SiluniPasqual/ParcelSafe-Locker/Final Project Report - ParcelSafe - 22UG2-0145,22UG2-0215_compressed.pdf

# ParcelSafe - Secure Delivery Locker System

MINI PROJECT REPORT

Embedded Systems Design Project

EEE2301

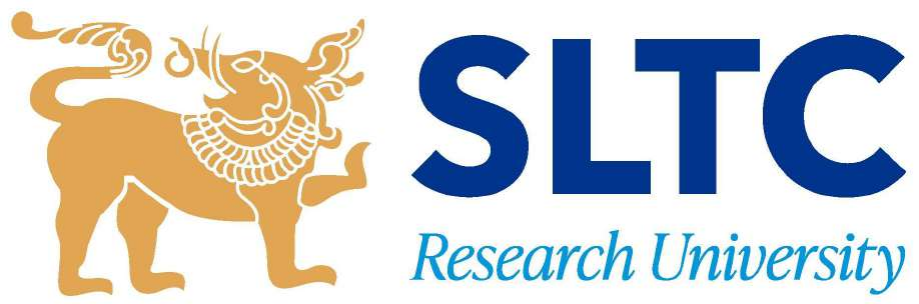
[picture p2: figure]

Group Members:

### 1. Siluni Pasqual – 22UG2-0145 2. Sasindu Basnayake – 22UG2-0215

Faculty of Engineering
SLTC Research University

AUGUST 2024

## Table of Contents

## CHAPTER 01 : INTRODUCTION

### 1.1 BACKGROUND OF THE PROJECT

In today’s fast-paced world, the rise in online shopping has led to increased home deliveries, but it also poses challenges like theft and missed deliveries when no one is home. ParcelSafe addresses this by offering a Secure Delivery Locker System. It provides a sturdy, weatherproof locker that ensures the safe delivery of packages even when the recipient is absent. Delivery personnel use a keypad to unlock the locker and deposit the parcel, while the recipient receives notifications via the Telegram app, allowing them to retrieve their package at their convenience.

### 1.2 FEATURES

- An Infrared (IR) sensor is integrated to detect the presence of a parcel upon door opening, activating a buzzer to indicate access and ensure the parcel is securely deposited inside the locker.
- A keypad entry system allows delivery personnel to enter a provided code. Only if ‘*’ is pressed will it ask the delivery personnel to enter the code. An LCD display shows messages such as "Enter Code," "Please wait," and "Granted."
- Each delivery personnel are provided with a same single code.
- A notification system is integrated to inform recipients in real-time upon parcel delivery via the Telegram app. Once the delivery personnel come to deliver the parcel, he should enter that code, and if he enters the correct code, the recipient is notified with a Telegram message whether to unlock the box. The box can be unlocked only if the user grants access via the Telegram App even if the correct code is entered, ensuring security of the box.
- The system is powered by a two separate 3.7V Li-ion rechargeable batteries, one to give power to the PIC, LCD, IR sensor and the ESP8266 Wi-Fi module, and the other to powerup the lock, with two boost converters (providing 5V and 10V outputs) for efficient power management.
- The user specified Wi-Fi SSID and its corresponding password are stored in the EEPROM of the ESP8266.
- A master password is provided with the manual, which can change the delivery code, which is provided to the delivery personnels, by entering this password. This password is only known by the user of the box.

## CHAPTER 02 : LITERATURE SURVEY

### 2.1 REVIEW OF THE EXISTING LITERATURE

### 1. Parcel Locker Networks

Overview and Functionality
Parcel locker networks consist of secure, automated series of postal boxes located in accessible central areas to facilitate package delivery and collection. These systems aim to simplify last-mile delivery by providing a flexible and convenient option for customers.

Applications

- Central Areas: Apartment complexes, office buildings, and business centers.
- Educational Institutions: Campuses and dormitories.
- Public locations: Parks, central business districts, and libraries.
- Logistics: Warehouses and distribution centers.

Case Study: Cainiao Smart Lockers in China

### 2. Vpod Automated Parcel Lockers

Overview and Functionality
The Vpod Automated Parcel Delivery Locker System automates the package delivery process, minimizing manual labor and enhancing security and convenience.

Applications

- Central Areas: Apartments, offices and business centers.
- Healthcare: Pharmacies and prescription deliveries.
- Hospitality: Hotels and other accommodation facilities.
- Educational Institutions: Campuses and schools for secure deliveries.

Case Study: Vpod in Office Buildings

## CHAPTER 03 : METHODOLOGY

### 3.1 BLOCK DIAGRAM AND DEVICE ARCHITECTURE

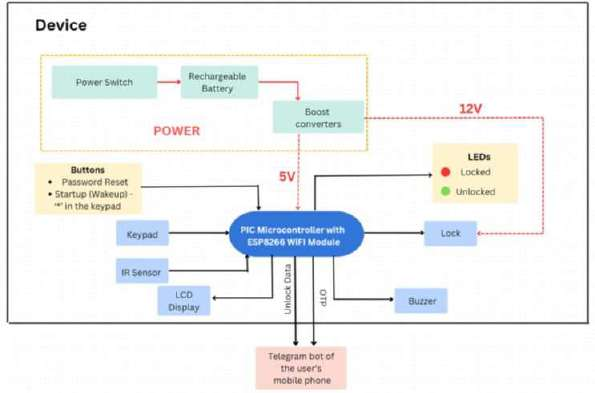
[picture p3: figure]

### 3.2 COMPONENT SELECTION AND CIRCUIT DESIGN

- Wi-Fi Module
The ESP8266 Wi-Fi module was selected for its reliable connectivity, compatibility with the PIC16F877A microcontroller, and cost-effectiveness. Its compact size and strong community support make it ideal for real-time communication with the Telegram bot, enabling remote monitoring and notifications. Wi-Fi was chosen over Bluetooth for its superior range, essential for long-distance connectivity.

Figure: ESP8266 Wi-Fi Module
- Lock
Two main electronically controlled lock designs were
considered,
- Solenoid lock
- Servo motor attached to a locking mechanism | Figure: Solenoid Lock

The servo motor-based design was rejected due to its low strength, limited durability, and higher cost. Instead, a solenoid lock was chosen for its greater strength and cost-effectiveness. Since the solenoid lock requires 10V-12V, a 5V relay was used to control it from the microcontroller, ensuring isolation between the low-power control circuit and the high-power lock circuit.

- Keypad
A 4x3 matrix array keypad was chosen to enable users to input numbers and to provide "ENTER" function.

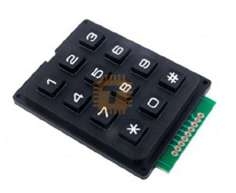
[picture p4: figure]

Figure: Keypad
- LED, Buzzer and Switch
An LED and a buzzer are used as indicators. A small push button switch is used to reset Wi-Fi.
- Sensors
Two options were considered when selecting a sensor to detect the door's status:
- A force sensor
- An IR sensor
After evaluating both options, the force sensor was found to have limitations: it can be easily damaged and may not reliably detect small, lightweight parcels such as documents. Additionally, there is a security concern where a thief could potentially manipulate the sensor by placing a weight to deceive it into registering an incorrect status. Therefore, the IR sensor was chosen for its reliability, durability, and ability to accurately detect whether the door is open or closed.

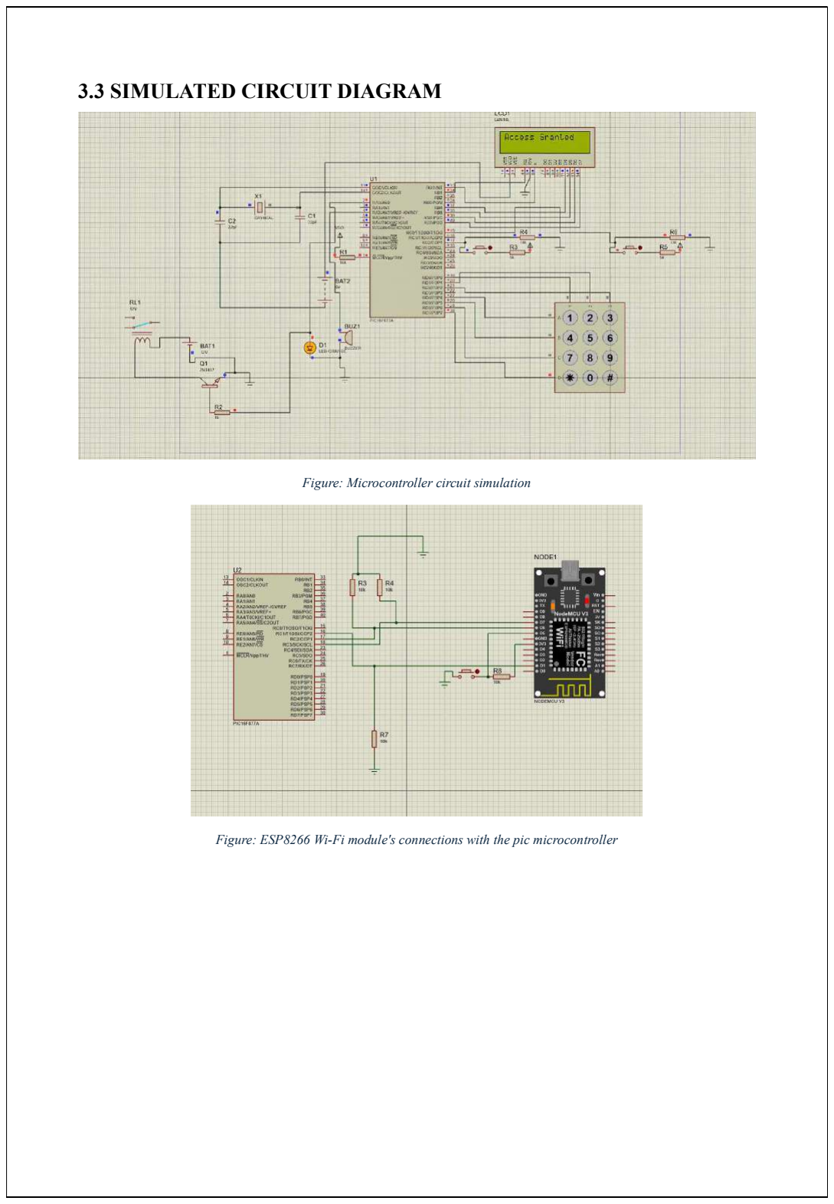
[picture p5: page 7]

### 3.3 SIMULATED CIRCUIT DIAGRAM

Figure: Microcontroller circuit simulation

Figure: ESP8266 Wi-Fi module's connections with the pic microcontroller

### 3.4 SCHEMATIC DESIGN AND PCB LAYOUT

The schematic and layout design for the PCB was done using the EasyEDA software.

### 3.4.1 Schematic Design

Figure: Power
circuit

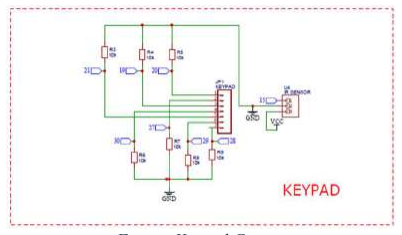
[picture p6: figure]

Figure: Keypad Circuit

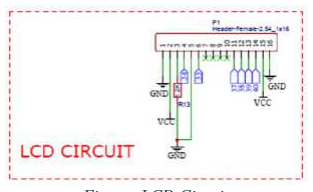
[picture p7: figure]

Figure: LCD Circuit

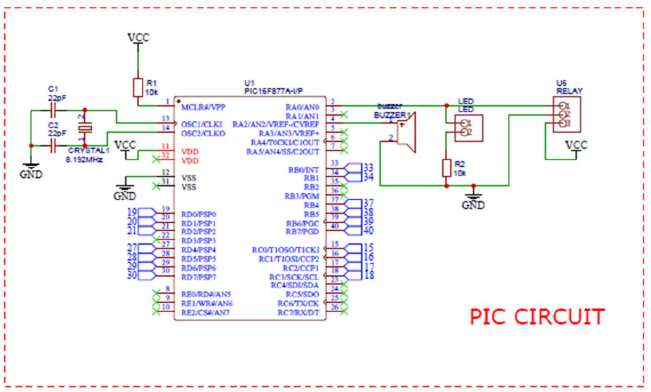
[picture p8: figure]

Figure: Microcontroller Circuit

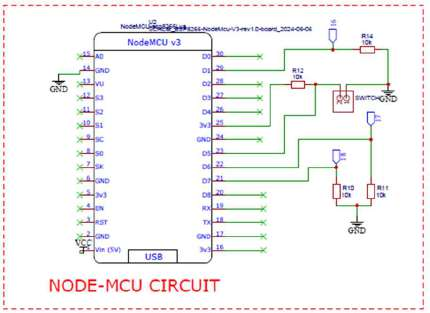
[picture p9: figure]

Figure: ESP8266 Wi-Fi Module Circuit

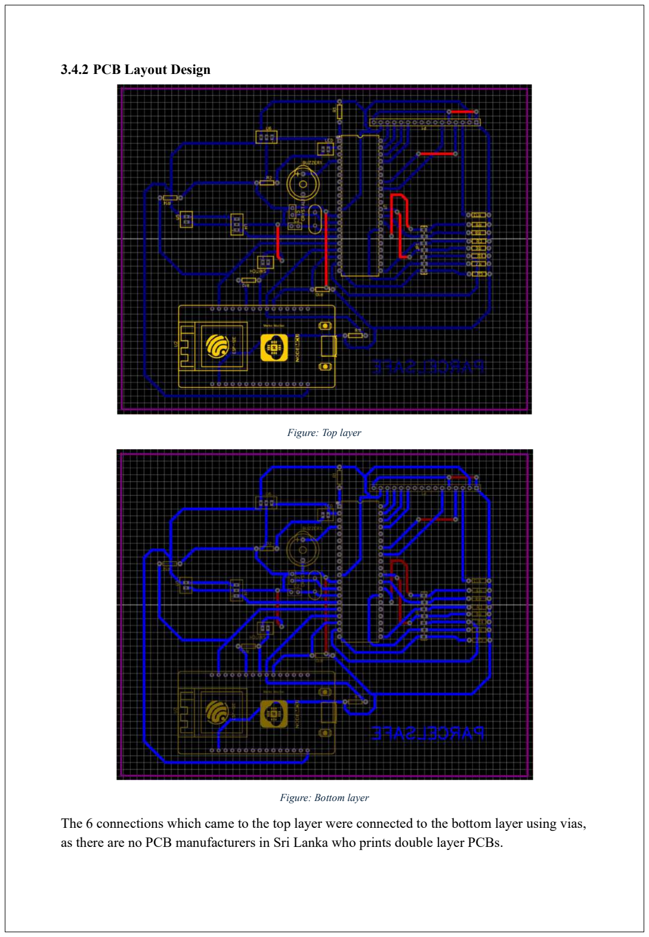
[picture p10: page 9]

### 3.4.2 PCB Layout Design

Figure: Top layer

Figure: Bottom layer
The 6 connections which came to the top layer were connected to the bottom layer using vias, as there are no PCB manufacturers in Sri Lanka who prints double layer PCBs.

### 3.4.3 PCB Manufacturing

PCB manufacturing was done by a Sri Lankan PCB Manufacturer.

PCB Specifications

- Dimensions: 15 cm x 12 cm
- PCB thickness: 0.8mm

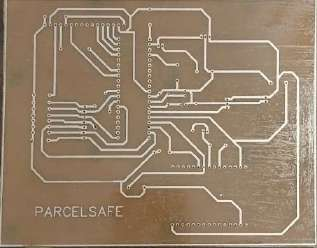
[picture p11: figure]

Figure: Manufactured PCB

### 3.5 ENCLOSURE DESIGN

### 3.5.1 SOLIDWORKS Design

Main Panel

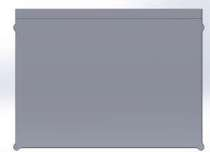
[picture p12: figure]

Figure: Panel (Main body)
Power circuit compartment

Figure: Compartment for power circuit

PCB after soldered and the Final Product

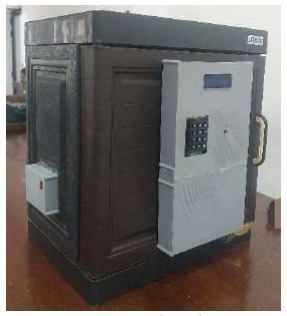
[picture p13: figure]
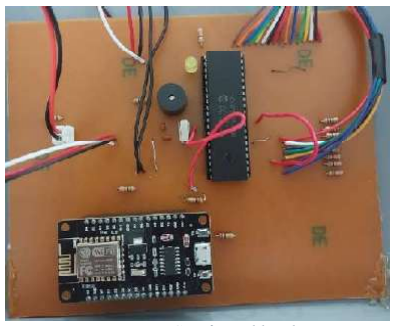
[picture p14: figure]

Figure: PCB after soldered | Figure: Final Product

### 3.5.2 Enclosure Manufacturing Methods

- The design of the box is based on an enclosure available in the market. This allows us to use this pre-made enclosure when manufacturing on the small scale in order to reduce costs.
- The panel containing electronic components was embedded into the door of the main box, and the compartment containing the power circuit was embedded into the side of the main box. These are designed as separate parts for easier manufacturing. For small scale manufacturing, this panel can also be manufactured by CNC machining a pre-made enclosure box and adding mounting spacers.
- For large scale manufacturing, both enclosures can be manufactured using injection molding. The design is made to meet injection molding requirements.
- For the prototype, a pre-made enclosure was used for the safe box and 3D printing was used for the remaining parts.

### 3.6 TOOLS, TECHNOLOGIES AND FRAMEWORKS EMPLOYED

### 3.6.1.1 Tools

- Hardware components:
- PIC16F877A microcontroller –
To program the device.
- Two separately connected 3.7V and 2 boost converters – for power supply to PIC and lock.
- IR sensor – to check the door opening.
- ESP8266 Wi-Fi module – to connect the device to Wi-Fi.
- Software components:
- mikroC Pro for PIC – to program the PIC microcontroller.
- Arduino IDE – managing the Telegram bot and configuring the ESP8266.

### 3.6.1.2 Technologies

- Programming languages:
- C programming language – for programming the
microcontroller.
- Arduino – for configuring ESP8266 and the Telegram bot.
- Communication protocols:
- Wi-Fi – for enabling real time communication between the
delivery locker and the
recipient’s Telegram App.
- Notification System:
- Integration with the Telegram bot to notify users about the lock/unlock status of the
delivery box.

### 3.6.1.3 Frameworks

- mikroC Pro for PIC Framework: Utilized for developing and managing the PIC’s code with built-in libraries for ease of development.
- Arduino Framework: Used for configuring the ESP8266 and managing the Telegram bot.
UniversalTelegramBot Library was used for implementing the Telegram bot, which handles notifications and communication with the user's mobile phone.
- EEPROM Library: Employed for storing codes in the Wi-Fi module's memory, ensuring persistent data storage even after power cycles.

## CHAPTER 04 : RESULTS AND ANALYSIS

### 4.1 OUTCOMES AND RESULTS OF THE PROJECT

These are the results from the proteus simulation:

- When the delivery driver enters the correct code, and the user gives permission from the telegram bot to unlock the delivery box.

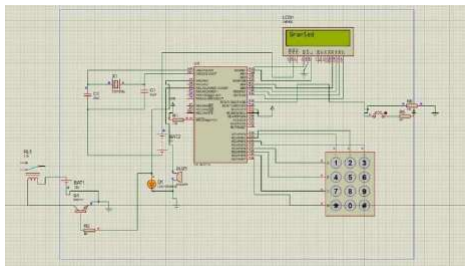
[picture p15: figure]
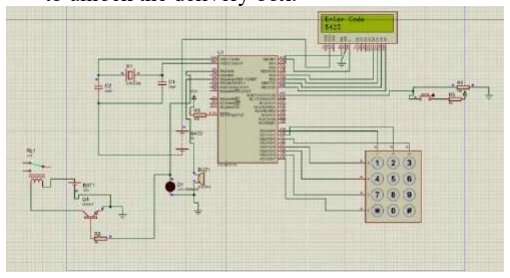
[picture p16: figure]
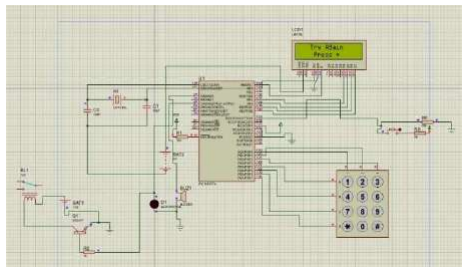
[picture p17: figure]

- When the delivery driver enters an incorrect code,

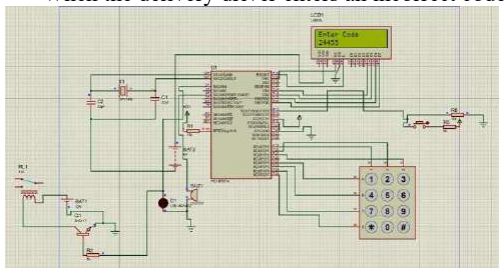
[picture p18: figure]

- When the delivery driver enters the correct code, the user doesn’t give permission from the telegram bot to unlock the delivery box.

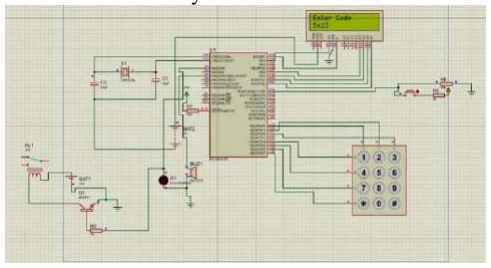
[picture p19: figure]

### 4.1.1 System Operation Workflow

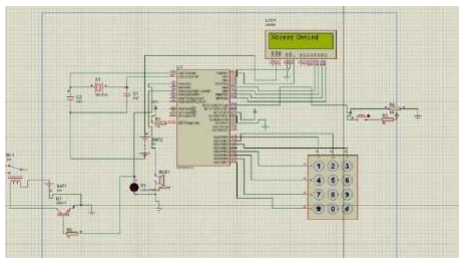
[picture p20: figure]

- The user enters the master password provided in the manual, to set a delivery code.
- The delivery driver is provided with the delivery code and enters it upon delivery.
- The Telegram app notifies the user, who then grants or denies access to the delivery box.

- The IR sensor confirms the presence of a parcel.
- The user specified Wi-Fi SSID and its corresponding password are stored in the EEPROM of the ESP8266.
1. Initialization: The LCD initializes and prompts the user to press the '*' key.

### 2. Code Entry: The display then shows "Enter code". The delivery driver contacts the

user to obtain this code and enters it, pressing '#' to submit.

### 3. Wi-Fi Configuration: The LCD screen displays "Please wait..." until the Wi-Fi

configuration is complete.

### 4. Wi-Fi Connection: The user connects to the ESP8266's Wi-Fi network and navigates

to the Wi-Fi configuration portal using any web browser.
5. Network Selection: The user selects a Wi-Fi network, enters the SSID and password, and connects to the network.

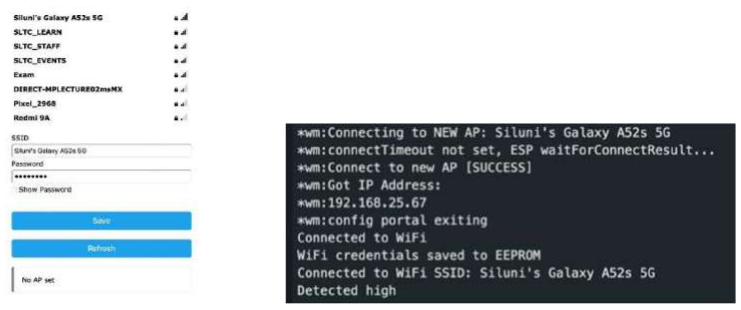
[picture p21: figure]

### 6. Notification and Approval: Once the Wi-Fi is connected, a message is sent via

Telegram asking whether to unlock the box, with two options: /YES and /NO.
- If /YES is given,

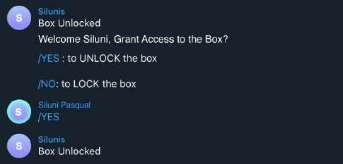
[picture p22: figure]

- If /NO is given,

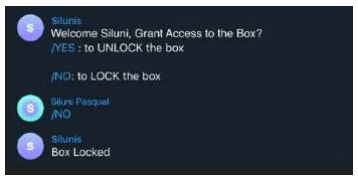
[picture p23: figure]
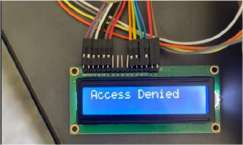
[picture p24: figure]

### 4.2 COMPARISON OF THE RESULTS WITH THE EXISTING

LITERATURE

When compared to existing solutions like parcel locker networks, Vpod Automated Parcel Lockers, and home secure parcel drop boxes, several key differences and improvements can be noted.

- Security:

Existing Solutions: Utilize access codes, QR codes, and facial recognition for security.

ParcelSafe: Enhances security with real-time user permissions via Telegram.

- Convenience:

Existing Solutions: Offer multiple authentication methods and 24/7 access to lockers.

ParcelSafe: Simplifies the process with a single code system, providing real-time notifications and easy user control, streamlining the user experience.

- Technological Integration:

Existing Solutions: Employ digital platforms for monitoring and management.

ParcelSafe: Integrates directly with Telegram for real-time user interaction.

### 4.3 WIFI CONNECTIVITY

In the ParcelSafe project, Wi-Fi connectivity, provided by the ESP8266 module configured with Arduino code, is crucial for real-time communication. It allows the system to send instant Telegram updates and alerts to users when the correct delivery code is entered, ensuring timely and secure package management.

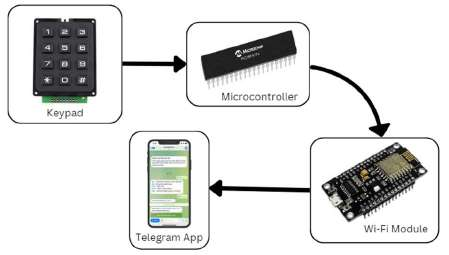
[picture p25: figure]

Figure: Connectivity

The ParcelSafe system operates as follows:

### 1. Connect to the ESP8266’s Network: The user connects their device to the

ESP8266’s network, which opens a captive portal automatically.

### 2. Configure Wi-Fi: In the captive portal, the user selects “Configure Wi-Fi,” chooses

the desired network, enters the SSID and password, and presses “Save.” A blinking blue LED indicates a successful connection.

### 3. Entering Code and Sending Notifications: When the correct code is entered on the

keypad, the system sends a Telegram message asking whether to grant access to the box. The user replies with /YES to unlock the box or /NO to keep it locked.

### 4. Resetting Wi-Fi: The Wi-Fi reset button allows the user to reconfigure the Wi-Fi

network settings as needed.

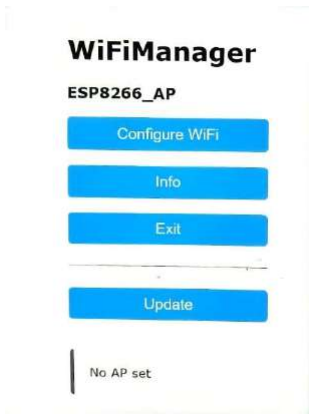
[picture p26: figure]
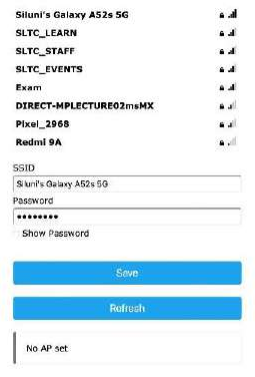
[picture p27: figure]
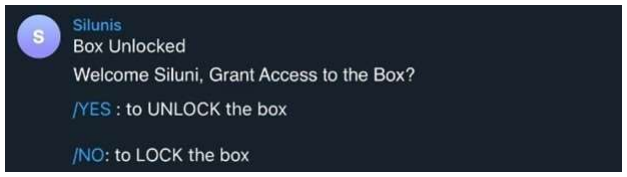
[picture p28: figure]

Figure: Wi-Fi settings interface and Telegram app's interface

## CHAPTER 05 : CONCLUSION AND FUTURE WORK

### 5.1 FUTURE RESEARCH OR IMPROVEMENTS

### 1. Enhanced Power Management:

- Provide a battery charging module with a micro-USB cable, allowing users to charge the batteries inside the box without removing them.
- Connect the box power supply to an AC source from the house for continuous power.

### 2. Advanced Security Features:

- Improve the current single code system by generating random OTPs for each delivery driver to enhance security.
- Replace the IR sensor with a camera module to verify if the delivery person is placing the parcel inside and to monitor if they attempt to steal any existing contents.

### 3. Integrated Mobile App:

- Develop a custom app for ParcelSafe, named "ParcelSecure".

### 4. Multiple Enclosure Design Options:

- Provide different enclosure designs for various use cases, such as: o A small-sized box for small parcels.
o A wall-mounted box powered by an AC source.
o A design with a separate compartment for small documents.
o Placing the components in the top section of the box, separated from user accessible compartment.

### 5. Emergency Access and Battery Management:

- Implement a method to open the door (e.g.: physical key) and place the parcel securely during a power outage or when the batteries are dead.
- Develop the app and system to provide battery status updates to the user, including warning messages when the battery is running low.

### 5.2 CONCLUSION

The ParcelSafe project successfully developed a prototype for a secure and automated delivery locker system, addressing the critical issue of unattended package deliveries. Through enhanced security measures, real-time notifications, and effective communication methods, ParcelSafe demonstrated its potential as a valuable solution for modern delivery challenges. Despite the encountered limitations, the project showcased the feasibility and benefits of such systems. Future research and improvements can further enhance ParcelSafe’s functionality, reliability, and user experience, solidifying its relevance and impact in the domain of secure package delivery solutions.

### 5.3 WORKPLAN

### 5.3.1 Project Timeline

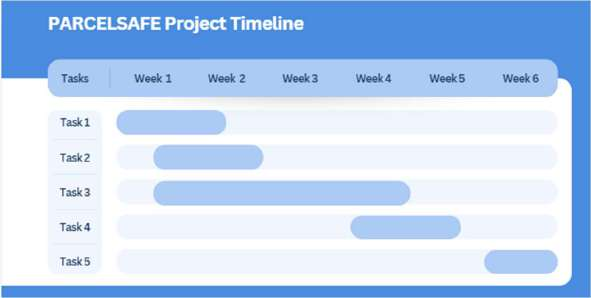
[picture p29: figure]

The tasks were,

Task 1: Finalizing and gathering components

Task 2: Creating the circuit

Task 3: Programming, testing, and troubleshooting

Task 4: Designing the PCB and soldering

Task 5: Integrating the PCB with the enclosure

### 5.3.2 Bill of Materials

Component | Quantity | Store | Unit Price (Rs.)
Solenoid Door Lock | 1 | Tronic.lk | 1180
5V Relay Module | 1 | Tronic.lk | 230
3.7V 1800mA Li-ion Battery | 1 | Tronic.lk | 400
5V Mini Buzzer | 1 | Tronic.lk | 30
4x3 Matrix Array Keypad switch module | 1 | Tronic.lk | 750
IR Sensor | 1 | Tronic.lk | 120
PIC Programming Adopter | 1 | Tronic.lk | 700
NodeMCU ESP8266 | 1 | Tronic.lk | 800
Boost Converter | 2 | Tronic.lk | 400
Rocker Switch | 1 | Tronic.lk | 10
16-Way PCB mount wire clip with socket | 1 | Tronic.lk | 110
Long 3-way PCB mount wire clip with socket | 1 | Tronic.lk | 25
Short 7-way PCB mount wire clip with socket | 1 | Tronic.lk | 50
Short 3-way PCB mount wire clip with socket | 1 | Tronic.lk | 20
40-oin single row female headers | 2 | Tronic.lk | 50

The price of the PIC microcontroller, LCD and one battery are removed as they were already bought for previous activities.

Rough cost of prototyping

Item | Cost
Electronic components | 4875
PCB | 650
3D printed enclosure parts | 8950
Pre-made enclosure box | 3500
Total | 17975

### 5.3.3 Proposed Product Price

When manufacturing in bulk at the small business level, the enclosure cost can be reduced significantly by avoiding 3D printing and using pre-made enclosures with CNC machining. The effect of cost on one unit will be reduced when components and PCBs are ordered in bulk. The unit price may also be reduced.

Manufacturing cost considering the above factors

Item | Cost
Electronic components | 3000
PCB | 300
Pre-made enclosure box | 5000
Total | 8800

Keeping a profit margin of Rs. 2000, the product can be sold at a price of around Rs. 11000. This is significantly cheaper than similar products currently available on the market.

## APPENDICES – PROGRAM CODE

PIC Microcontroller code using mikroC PRO for PIC

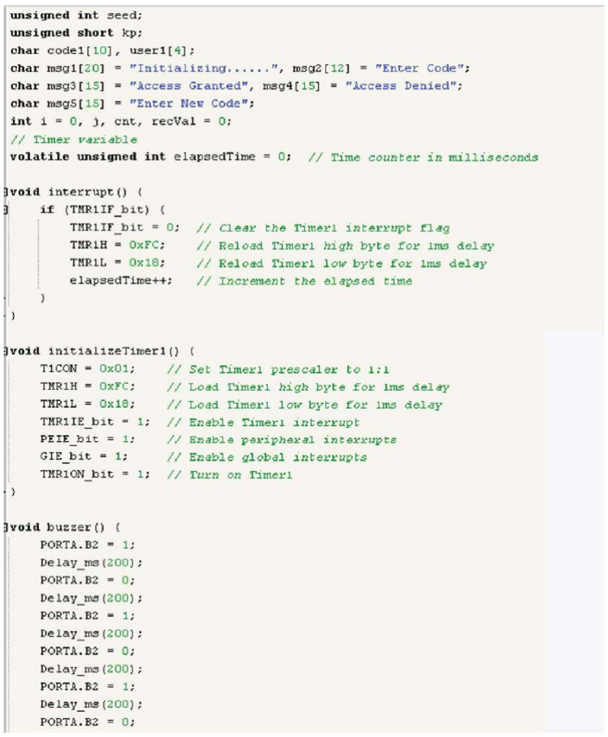
[picture p30: figure]

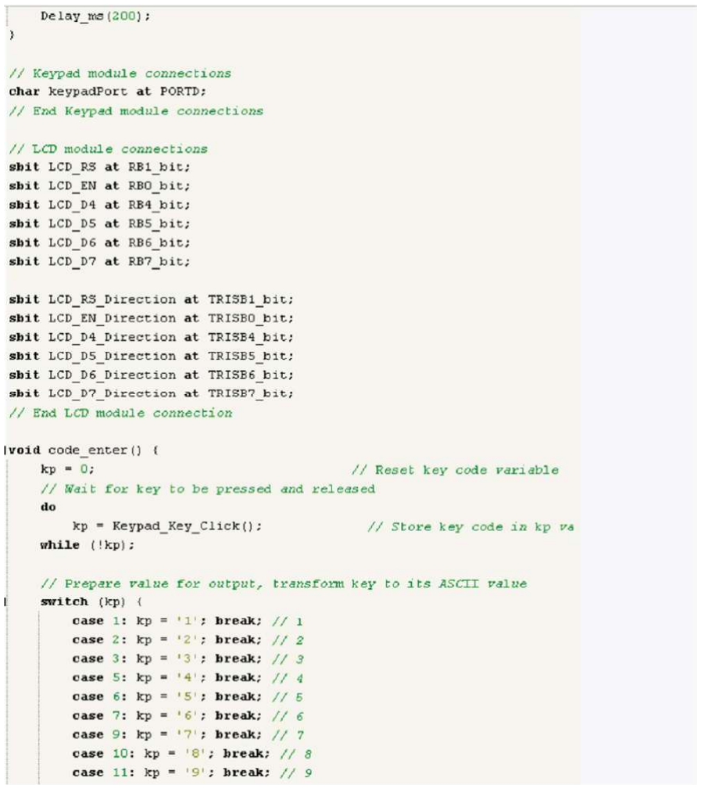
[picture p31: figure]

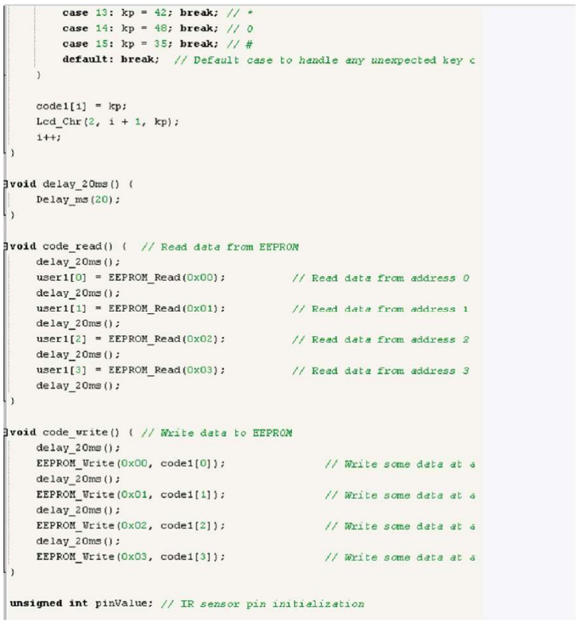
[picture p32: figure]

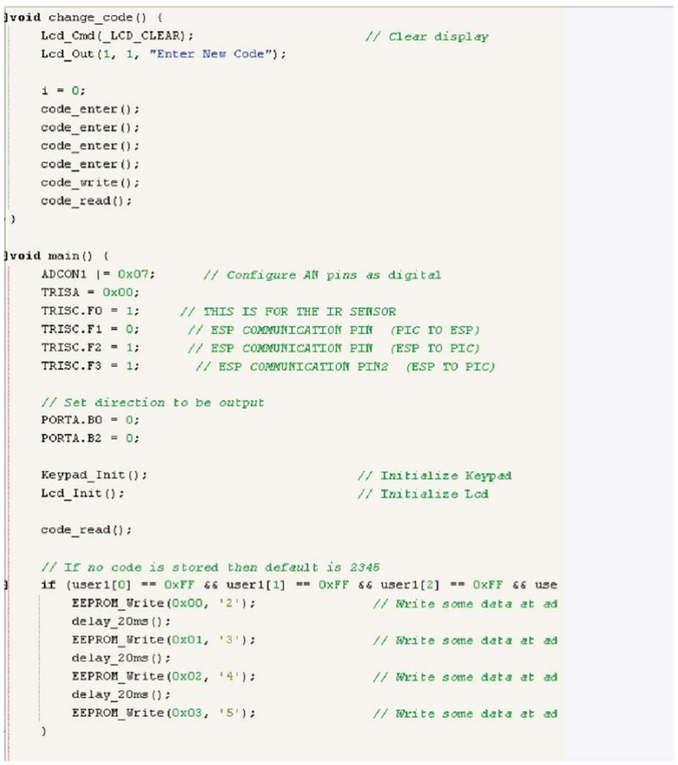
[picture p33: figure]

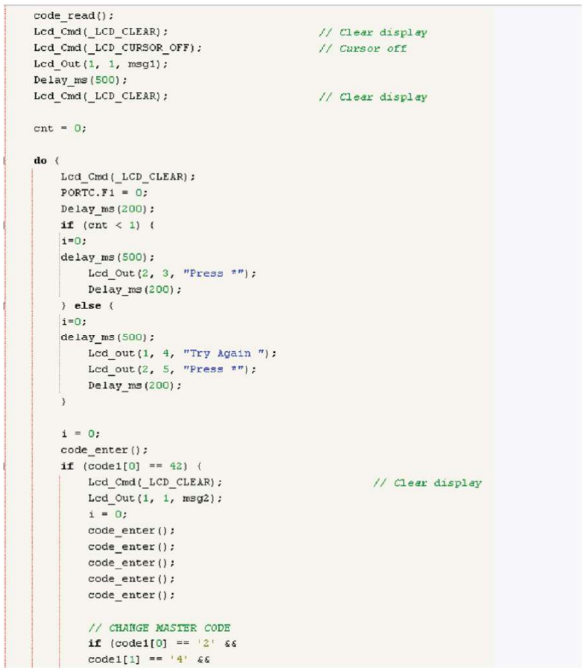
[picture p34: figure]

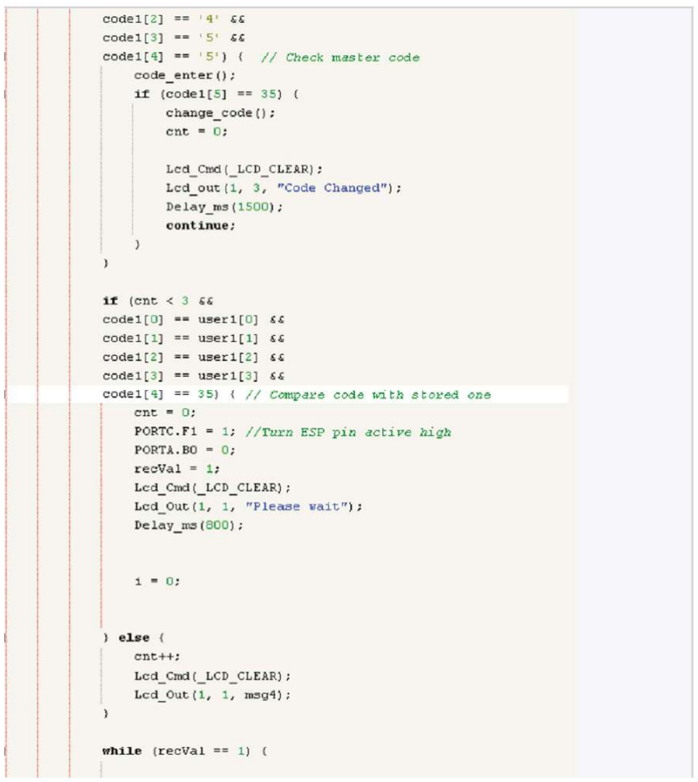
[picture p35: figure]
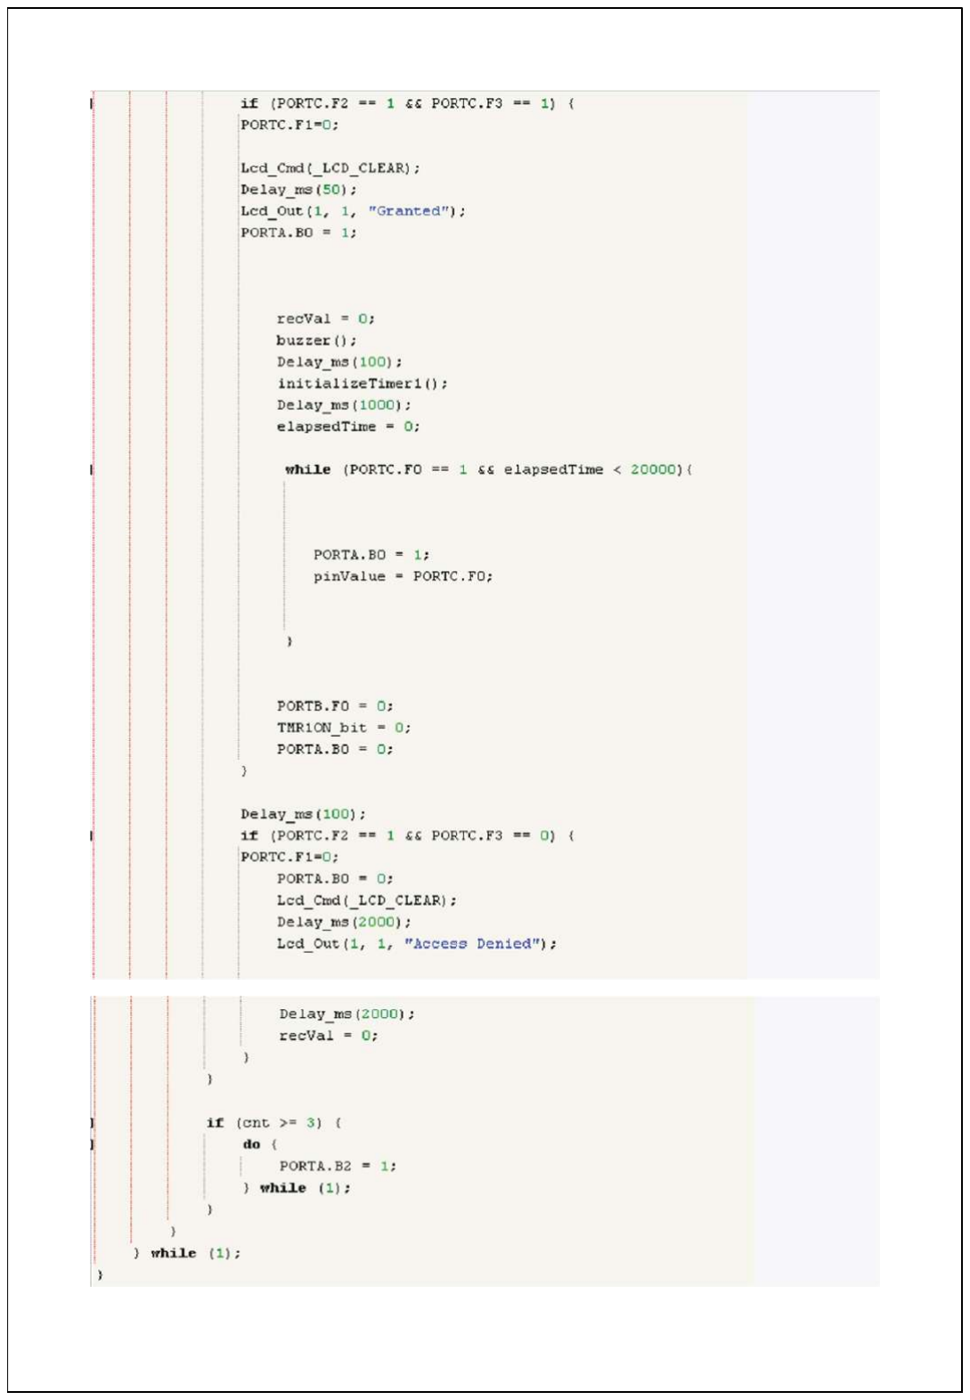
[picture p36: page 26]

ESP8266 Wi-Fi Module’s code using Arduino IDE

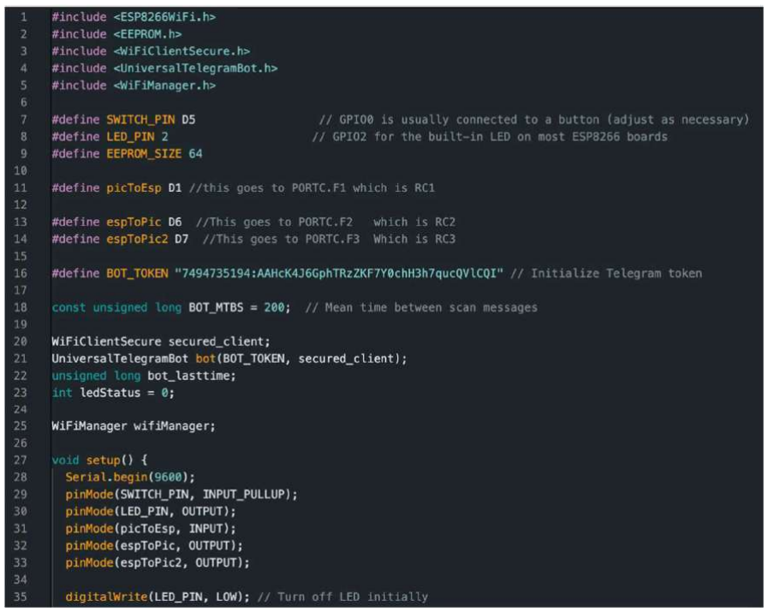
[picture p37: figure]

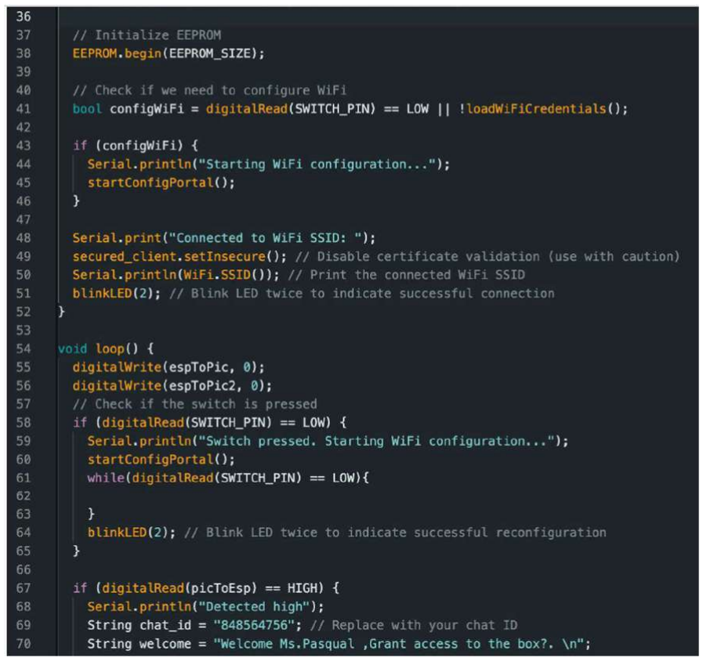
[picture p38: figure]

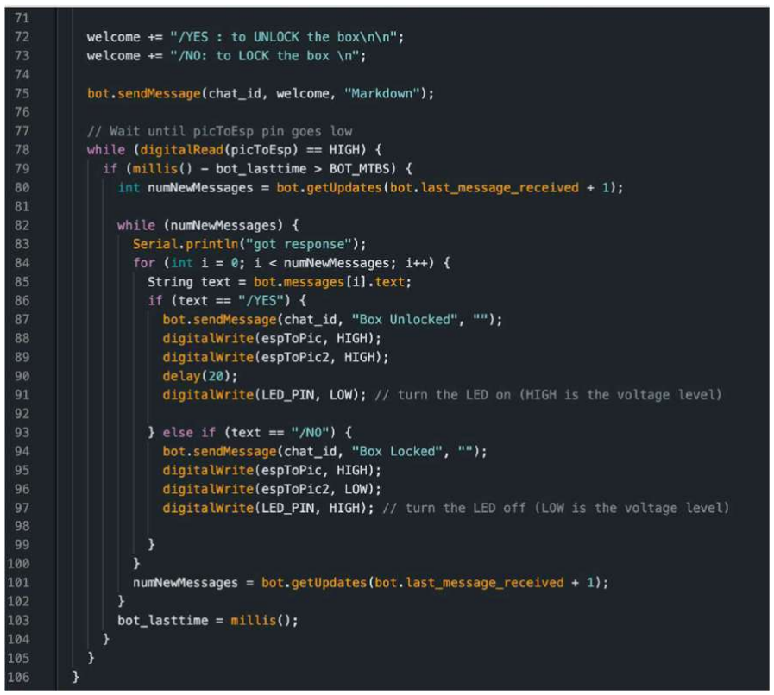
[picture p39: figure]

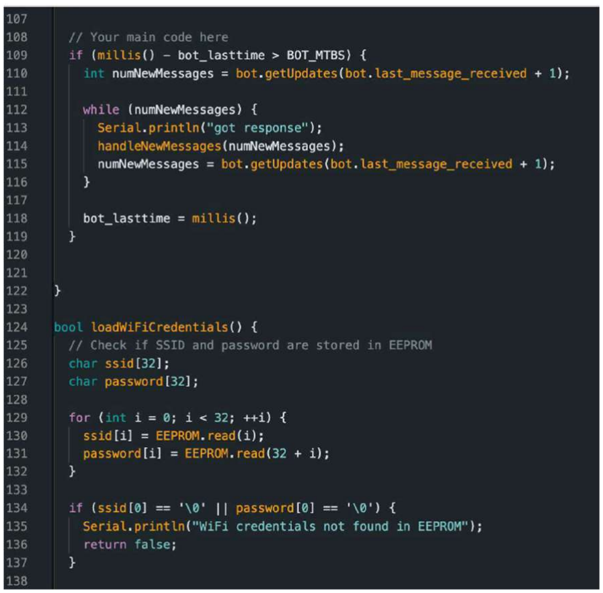
[picture p40: figure]

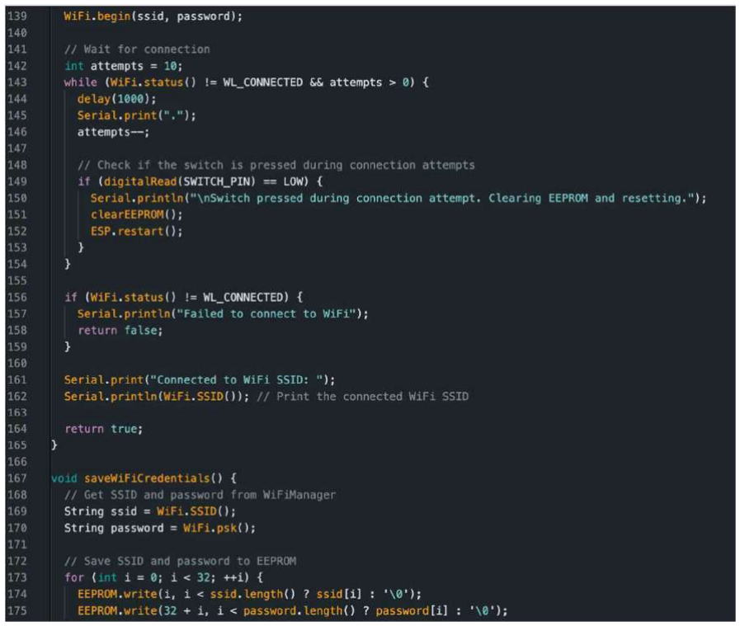
[picture p41: figure]

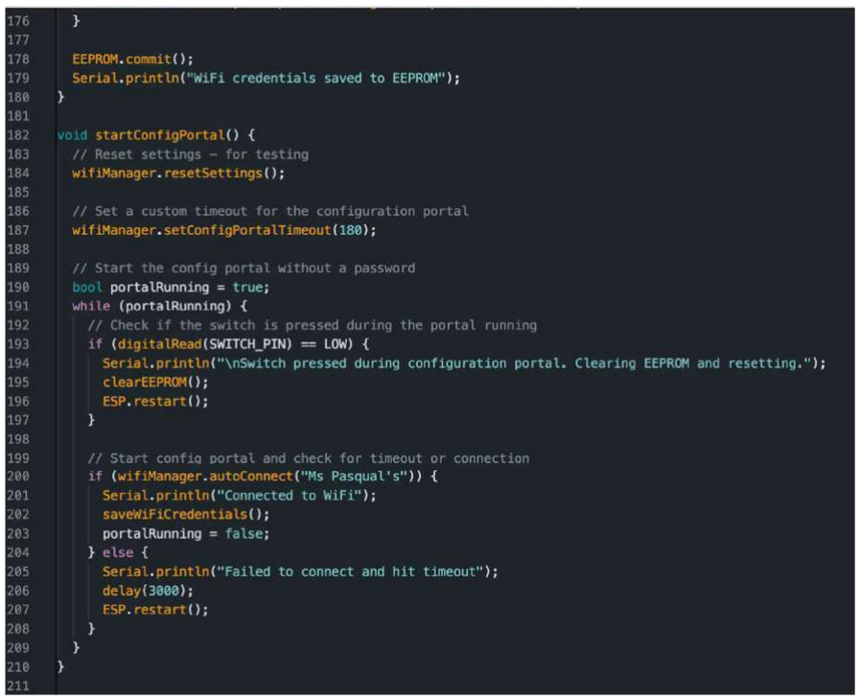
[picture p42: figure]
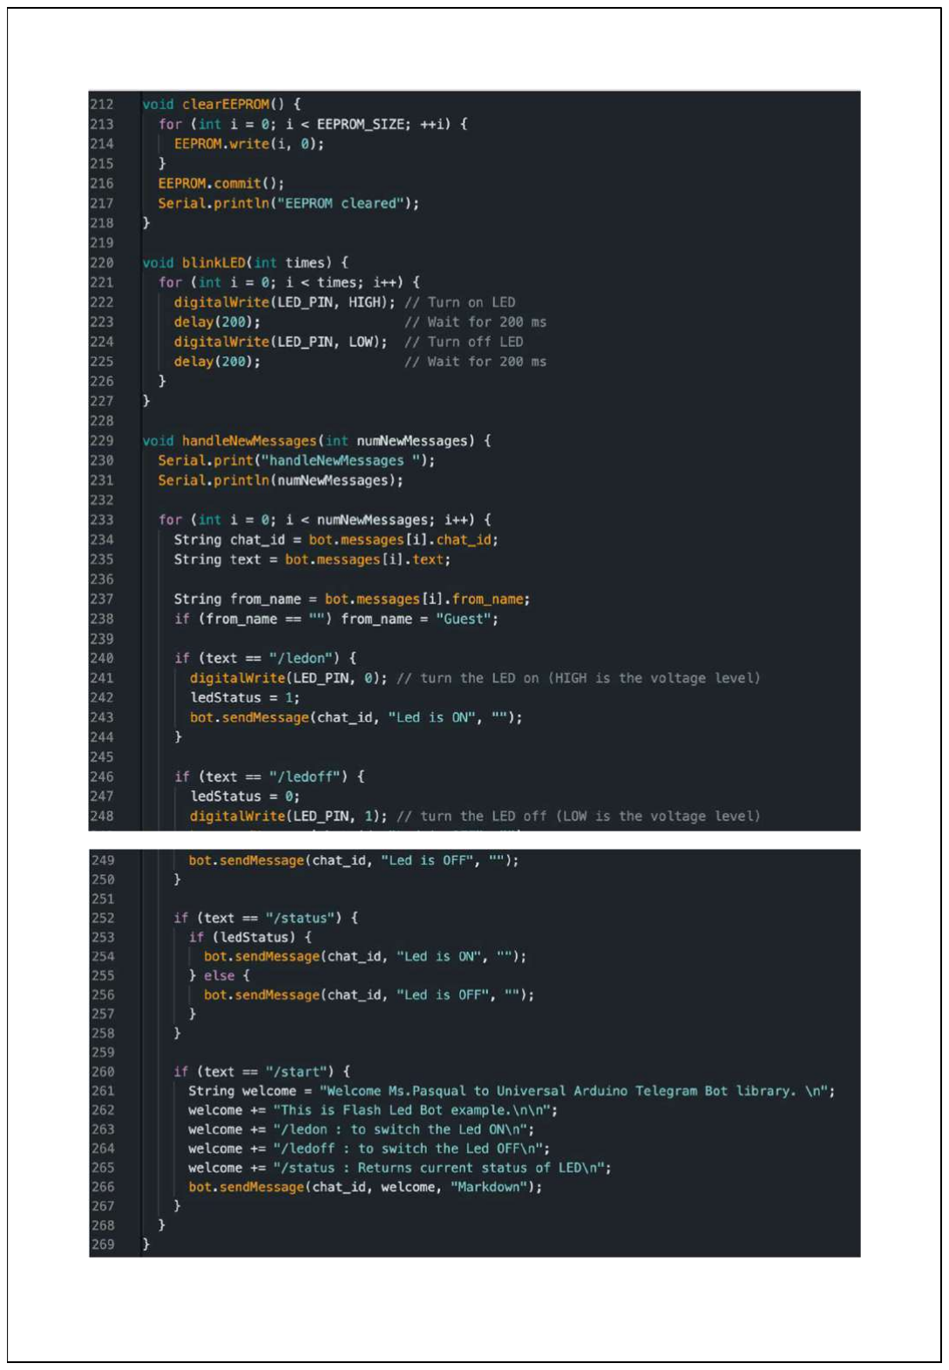
[picture p43: page 33]

## REFERENCES

[1] “PIC16F87XA Data Sheet 28/40/44-Pin Enhanced Flash Microcontrollers.”

Available: https://ww1.microchip.com/downloads/en/devicedoc/39582b.pdf

[2] “ESP8266EX Datasheet.” Available: https://www.espressif.com/sites/default/files/documentation/0a-esp8266ex_datasheet_en.pdf
[3] “Interfacing 4x3 Membrane Matrix Keypad with Arduino,” Electropeak, Feb. 13, 2021. https://electropeak.com/learn/interfacing-4x3-membrane-matrix-keypad-with-arduino/
[4] V. K. M, “vishaletm/Pic-16F877A-Based-Code-Lock-16x2-LCD-Keypad,” GitHub, Mar. 25, 2024. https://github.com/vishaletm/Pic-16F877A-Based-Code-Lock-16x2-LCD-Keypad
[5] B. Lough, “Universal Telegram Bot Library,” GitHub, Nov. 11, 2023. https://github.com/witnessmenow/Universal-Arduino-Telegram-Bot/tree/master
[6] M. Technology, “IR Sensor interfacing with microcontroller (Mikro C),” MINA TECHNOLOGY. https://minatechnologysupport.blogspot.com/2019/08/ir-sensor-interfacing-with.html
