SiluniPasqual/ParcelSafe-Locker/pcb/Schematic.pdf

## NodeMCU v3

## GND

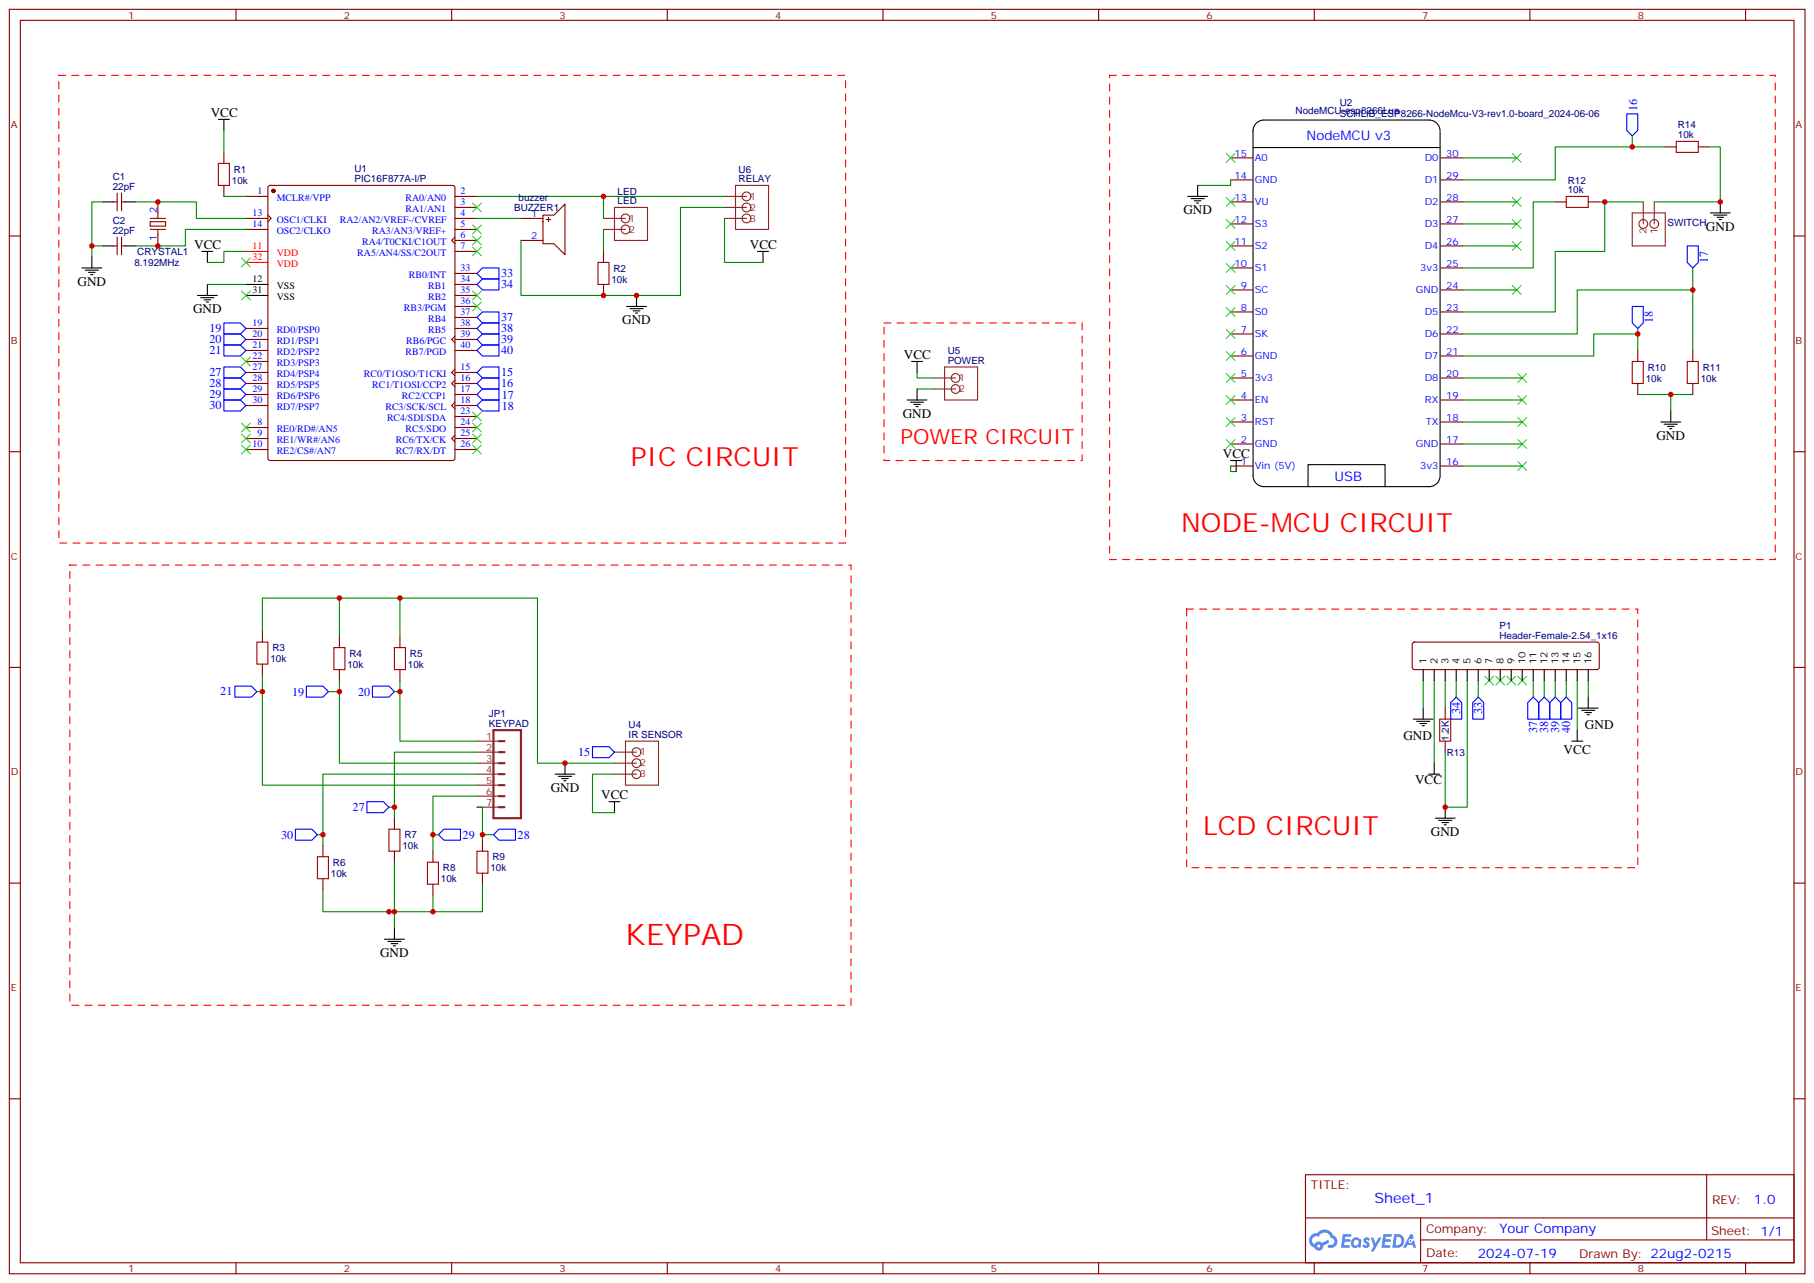
[picture p44: page 1]
