SiluniPasqual/ParcelSafe-Locker/(list of files, drawings)

Other design files:
pcb/pcb_layout.json
pcb/PCB_PCB_PCB_ParcelSafe_2024-07-23_2024-07-29.json
